hhaudio/FlailDriver/FlailDriver.kicad_pcb

## KiCad design FlailDriver.kicad_pcb (2023-05-16)

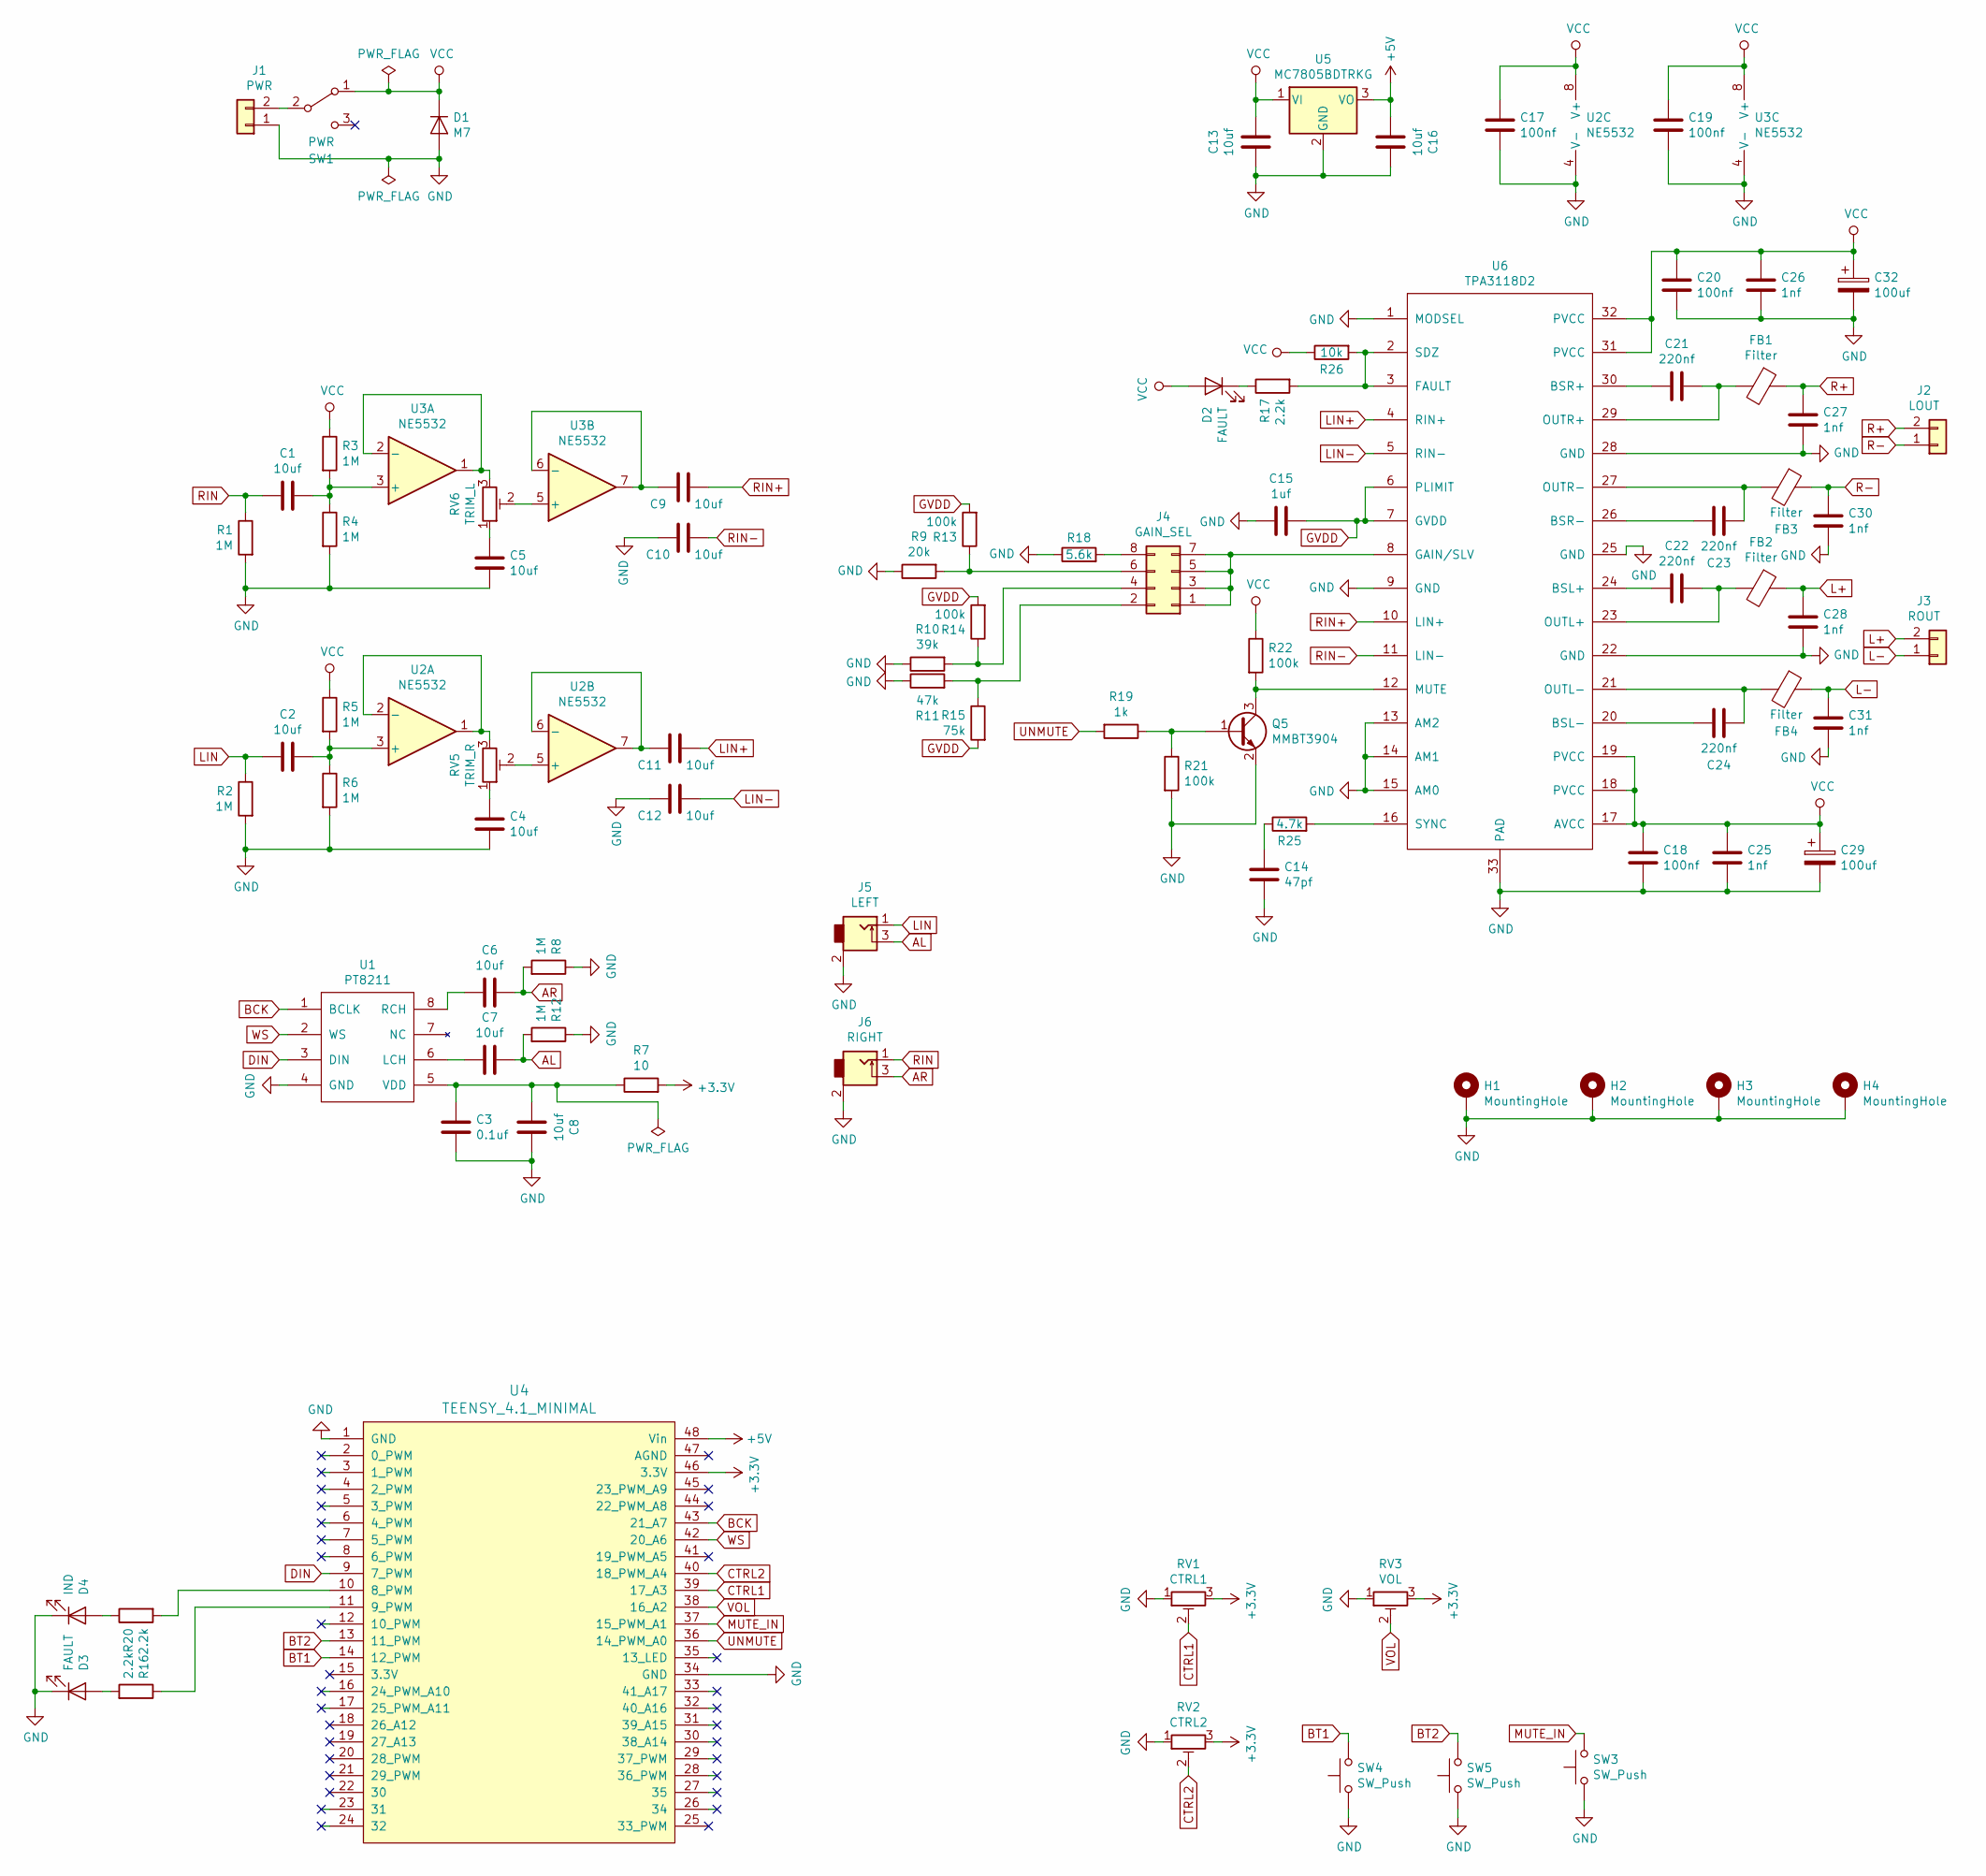
[picture p1: schematic FlailDriver.sch]

Parts:
C1, C2, C4, C5, C6, C7, C8, C9, C10, C11, C12, C13, C16: 10uf; C_0603_1608Metric_Pad1.05x0.95mm_HandSolder_HiddenRef; LCSC C96446
C3: 0.1uf; C_0603_1608Metric_Pad1.05x0.95mm_HandSolder_HiddenRef; LCSC C14663
C14: 47pf; C_0603_1608Metric_Pad1.05x0.95mm_HandSolder_HiddenRef; LCSC C1671
C15: 1uf; C_0603_1608Metric_Pad1.05x0.95mm_HandSolder_HiddenRef; LCSC C15849
C17, C18, C19, C20: 100nf; C_0603_1608Metric_Pad1.05x0.95mm_HandSolder_HiddenRef; LCSC C14663
C21, C22, C23, C24: 220nf; C_0603_1608Metric_Pad1.05x0.95mm_HandSolder_HiddenRef; LCSC C21120
C25, C26, C27, C28, C30, C31: 1nf; C_0603_1608Metric_Pad1.05x0.95mm_HandSolder_HiddenRef; LCSC C1588
C29, C32: 100uf; CP_Elec_6.3x7.7; LCSC C311622
D1: M7; D_SMA; LCSC C95872
D2, D3: FAULT; LED_0805_2012Metric_Pad1.15x1.40mm_HandSolder; LCSC C84256
D4: IND; LED_0805_2012Metric_Pad1.15x1.40mm_HandSolder; LCSC C84256
FB1, FB2, FB3, FB4: Filter; L_1206_3216Metric_Pad1.42x1.75mm_HandSolder; LCSC C124704
H1, H2, H3, H4: MountingHole; M3_Plated
J1: PWR; Phoenix_Stacked_BackSilk_Centered_BoardEdge; LCSC C430323
J2: LOUT; Phoenix_Stacked_BackSilk_Centered_BoardEdge; LCSC C430323
J3: ROUT; Phoenix_Stacked_BackSilk_Centered_BoardEdge; LCSC C430323
J4: GAIN_SEL; PinHeader_2x04_P2.54mm_Vertical_SMD; LCSC C192300
J5: LEFT; EuroJack_MonoSW_THT_NOREF_SmallHoles_NoSilk
J6: RIGHT; EuroJack_MonoSW_THT_NOREF_SmallHoles_NoSilk
Q5: MMBT3904; SOT-23; LCSC C20526
R1, R2, R3, R4, R5, R6, R8, R12: 1M; R_0603_1608Metric_Pad1.05x0.95mm_HandSolder_HiddenRef; LCSC C22935
R7: 10; R_0603_1608Metric_Pad1.05x0.95mm_HandSolder_HiddenRef; LCSC C22859
R9: 20k; R_0603_1608Metric_Pad1.05x0.95mm_HandSolder_HiddenRef; LCSC C4184
R10: 39k; R_0603_1608Metric_Pad1.05x0.95mm_HandSolder_HiddenRef; LCSC C23153
R11: 47k; R_0603_1608Metric_Pad1.05x0.95mm_HandSolder_HiddenRef; LCSC C25819
R13, R14, R21, R22: 100k; R_0603_1608Metric_Pad1.05x0.95mm_HandSolder_HiddenRef; LCSC C25803
R15: 75k; R_0603_1608Metric_Pad1.05x0.95mm_HandSolder_HiddenRef; LCSC C23242
R16, R17, R20: 2.2k; R_0603_1608Metric_Pad1.05x0.95mm_HandSolder_HiddenRef; LCSC C4190
R18: 5.6k; R_0603_1608Metric_Pad1.05x0.95mm_HandSolder_HiddenRef; LCSC C23189
R19: 1k; R_0603_1608Metric_Pad1.05x0.95mm_HandSolder_HiddenRef; LCSC C21190
R25: 4.7k; R_0603_1608Metric_Pad1.05x0.95mm_HandSolder_HiddenRef; LCSC C23162
R26: 10k; R_0603_1608Metric_Pad1.05x0.95mm_HandSolder_HiddenRef; LCSC C25804
RV1: CTRL1; SMD_TRIM_JLC; LCSC C128550
RV2: CTRL2; SMD_TRIM_JLC; LCSC C128550
RV3: VOL; SMD_TRIM_JLC; LCSC C128550
RV5: TRIM_R; SMD_TRIM_JLC; LCSC C128550
RV6: TRIM_L; SMD_TRIM_JLC; LCSC C128550
SW1: PWR; JLC_SPDT_SLIDE_3A_C2887258; LCSC C2887258
SW3, SW4, SW5: SW_Push; JLC_TactileSw_C318884; LCSC C318884
U1: PT8211; SOIC-8_3.9x4.9mm_P1.27mm; LCSC C5260468
U2, U3: NE5532; SO-8_3.9x4.9mm_P1.27mm; LCSC C7426
U4: TEENSY_4.1_MINIMAL; TEENSY_4.1_MINIMAL_DROP_IN
U5: MC7805BDTRKG; TO-252-2; LCSC C110908
U6: TPA3118D2; HTSSOP-32-1EP_6.1x11mm_P0.65mm_EP5.2x11mm_Mask4.11x4.36mm_T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; LCSC C46497

Connections:
+3V3: R7.2, RV1.3, RV2.3, RV3.3, U4.46 (3.3V)
+5V: C16.1, U4.48 (Vin), U5.3 (VO)
AL: C7.1, J5.3, R12.2
AR: C6.1, J6.3, R8.2
BCK: U1.1 (BCLK), U4.43 (21_A7)
BT1: SW4.2, U4.14 (12_PWM)
BT2: SW5.2, U4.13 (11_PWM)
CTRL1: RV1.2, U4.39 (17_A3)
CTRL2: RV2.2, U4.40 (18_PWM_A4)
DIN: U1.3 (DIN), U4.9 (7_PWM)
GND: C3.2, C4.2, C5.2, C8.2, C10.2, C12.2, C13.2, C14.2, C15.2, C16.2, C17.2, C18.2, C19.2, C20.2, C25.2, C26.2, C27.2, C28.2, C29.2, C30.2, C31.2, C32.2, D1.2 (A), D3.1 (K), D4.1 (K), H1.1, H2.1, H3.1, H4.1, J1.1, J5.2, J6.2, Q5.2 (E), R1.2, R2.2, R4.2, R6.2, R8.1, R9.1, R10.1, R11.1, R12.1, R18.1, R21.2, RV1.1, RV2.1, RV3.1, SW3.1, SW4.1, SW5.1, U1.4 (GND), U2.4 (V-), U3.4 (V-), U4.1 (GND), U4.34 (GND), U5.2 (GND), U6.1 (MODSEL), U6.9 (GND), U6.13 (AM2), U6.14 (AM1), U6.15 (AM0), U6.22 (GND), U6.25 (GND), U6.28 (GND), U6.33 (PAD)
GVDD: C15.1, R13.2, R14.2, R15.2, U6.6 (PLIMIT), U6.7 (GVDD)
L+: C28.1, FB2.1, J3.2
L-: C31.1, FB4.1, J3.1
LIN: C2.2, J5.1, R2.1
LIN+: C11.1, U6.4 (RIN+)
LIN-: C12.1, U6.5 (RIN-)
MUTE_IN: SW3.2, U4.37 (15_PWM_A1)
unnamed: C1.1, R3.2, R4.1, U3.3 (+)
unnamed: C2.1, R5.2, R6.1, U2.3 (+)
unnamed: C3.1, C8.1, R7.1, U1.5 (VDD)
unnamed: C4.1, RV5.1
unnamed: C5.1, RV6.1
unnamed: C6.2, U1.8 (RCH)
unnamed: C7.2, U1.6 (LCH)
unnamed: C9.2, U3.6 (-), U3.7
unnamed: C11.2, U2.6 (-), U2.7
unnamed: C14.1, R25.1
unnamed: C21.1, FB1.2, U6.29 (OUTR+)
unnamed: C21.2, U6.30 (BSR+)
unnamed: C22.1, FB2.2, U6.23 (OUTL+)
unnamed: C22.2, U6.24 (BSL+)
unnamed: C23.1, U6.26 (BSR-)
unnamed: C23.2, FB3.2, U6.27 (OUTR-)
unnamed: C24.1, U6.20 (BSL-)
unnamed: C24.2, FB4.2, U6.21 (OUTL-)
unnamed: D2.1 (K), R17.1
unnamed: D3.2 (A), R16.2
unnamed: D4.2 (A), R20.1
unnamed: J1.2, SW1.2 (B)
unnamed: J4.1, J4.3, J4.5, J4.7, U6.8 (GAIN/SLV)
unnamed: J4.2, R11.2, R15.1
unnamed: J4.4, R10.2, R14.1
unnamed: J4.6, R9.2, R13.1
unnamed: J4.8, R18.2
unnamed: Q5.1 (B), R19.1, R21.1
unnamed: Q5.3 (C), R22.2, U6.12 (MUTE)
unnamed: R16.1, U4.11 (9_PWM)
unnamed: R17.2, R26.2, U6.2 (SDZ), U6.3 (FAULT)
unnamed: R20.2, U4.10 (8_PWM)
unnamed: R25.2, U6.16 (SYNC)
unnamed: RV5.2, U2.5 (+)
unnamed: RV5.3, U2.1, U2.2 (-)
unnamed: RV6.2, U3.5 (+)
unnamed: RV6.3, U3.1, U3.2 (-)
R+: C27.1, FB1.1, J2.2
R-: C30.1, FB3.1, J2.1
RIN: C1.2, J6.1, R1.1
RIN+: C9.1, U6.10 (LIN+)
RIN-: C10.1, U6.11 (LIN-)
UNMUTE: R19.2, U4.36 (14_PWM_A0)
VCC: C13.1, C17.1, C18.1, C19.1, C20.1, C25.1, C26.1, C29.1, C32.1, D1.1 (K), D2.2 (A), R3.1, R5.1, R22.1, R26.1, SW1.1 (A), U2.8 (V+), U3.8 (V+), U5.1 (VI), U6.17 (AVCC), U6.18 (PVCC), U6.19 (PVCC), U6.31 (PVCC), U6.32 (PVCC)
VOL: RV3.2, U4.38 (16_A2)
WS: U1.2 (WS), U4.42 (20_A6)

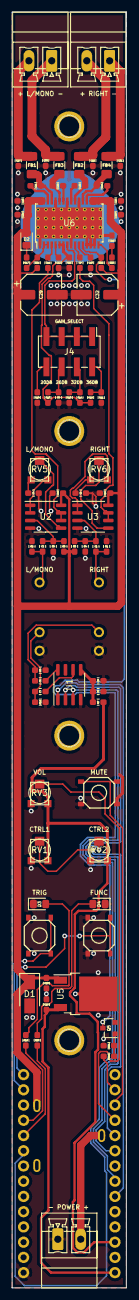
[picture p2: board FlailDriver.kicad_pcb from above]

Board: 2 copper layers, 19.0 x 212.7 mm, 90 parts (1 on the bottom side), 64 nets.
