hhaudio/FlailDriver/(commit log)

2023-05-13 schematic, start on layout
    [FlailDriver.kicad_pcb, FlailDriver.sch]
2023-05-15 commit before routing traces
    [FlailDriver.kicad_pcb, FlailDriver.sch]
2023-05-15 layout progress
    [FlailDriver.kicad_pcb, FlailDriver.sch]
2023-05-16 layout finished
    [FlailDriver-B_Cu.gbr, FlailDriver-B_Mask.gbr, FlailDriver-B_Paste.gbr, FlailDriver-B_SilkS.gbr, FlailDriver-Edge_Cuts.gbr, FlailDriver-F_Cu.gbr, FlailDriver-F_Mask.gbr, FlailDriver-F_Paste.gbr]
